yalcins/physical-ai/README.md

# Physical AI – 11/12. Sınıf Robotik Projesi
