yalcins/physical-ai/design/pcb/netlist.csv

net | ref | pin_no | pin_name
GND | U1 | 38 | GND_38
GND | J1 | 8 | GND
GND | J9 | 2 | -
GND | R2 | 2 | 2
GND | C1 | 2 | 2
GND | C2 | 2 | -
GND_L | U1 | 3 | GND_3
GND_L | J3 | 1 | GND
GND_L | J4 | 1 | GND
GND_L | J5 | 1 | GND
GND_L | J7 | 1 | ENC_GND
GND_L | J8 | 1 | ENC_GND
GND_L | C4 | 2 | 2
+3V3 | U1 | 36 | 3V3_OUT
+3V3 | W2 | 1 | 1
+3V3_L | W2 | 2 | 2
+3V3_L | J3 | 2 | VIN
+3V3_L | J4 | 2 | VIN
+3V3_L | J5 | 2 | VIN
+3V3_L | J7 | 2 | ENC_VCC
+3V3_L | J8 | 2 | ENC_VCC
+3V3_L | C4 | 1 | 1
VSYS | D1 | 1 | K
VSYS | U1 | 39 | VSYS
VBAT_SW | J9 | 1 | +
VBAT_SW | J1 | 10 | VM
VBAT_SW | J1 | 9 | VCC
VBAT_SW | D1 | 2 | A
VBAT_SW | R1 | 1 | 1
VBAT_SW | C2 | 1 | +
I2C_SDA | U1 | 6 | GP4
I2C_SDA | J3 | 3 | SDA
I2C_SDA | J4 | 3 | SDA
I2C_SDA | J5 | 3 | SDA
I2C_SCL | U1 | 7 | GP5
I2C_SCL | J3 | 4 | SCL
I2C_SCL | J4 | 4 | SCL
I2C_SCL | J5 | 4 | SCL
XSHUT_L | U1 | 9 | GP6
XSHUT_L | J3 | 5 | XSHUT
XSHUT_C | U1 | 10 | GP7
XSHUT_C | J4 | 5 | XSHUT
XSHUT_R | U1 | 11 | GP8
XSHUT_R | J5 | 5 | XSHUT
ENC_L_A | U1 | 14 | GP10
ENC_L_A | J7 | 3 | ENC_A
ENC_L_B | U1 | 15 | GP11
ENC_L_B | J7 | 4 | ENC_B
ENC_R_A | U1 | 16 | GP12
ENC_R_A | J8 | 3 | ENC_A
ENC_R_B | U1 | 17 | GP13
ENC_R_B | J8 | 4 | ENC_B
PWMA | U1 | 21 | GP16
PWMA | J1 | 1 | PWMA
AIN1 | U1 | 22 | GP17
AIN1 | J1 | 2 | AIN1
AIN2 | U1 | 24 | GP18
AIN2 | J1 | 3 | AIN2
BIN1 | U1 | 25 | GP19
BIN1 | J1 | 4 | BIN1
BIN2 | U1 | 26 | GP20
BIN2 | J1 | 5 | BIN2
PWMB | U1 | 27 | GP21
PWMB | J1 | 6 | PWMB
STBY | U1 | 29 | GP22
STBY | J1 | 7 | STBY
VBAT_SENSE | U1 | 31 | GP26
VBAT_SENSE | R1 | 2 | 2
VBAT_SENSE | R2 | 1 | 1
VBAT_SENSE | C1 | 1 | 1
