yalcins/physical-ai/docs/media/design/render-pi4-exploded.png

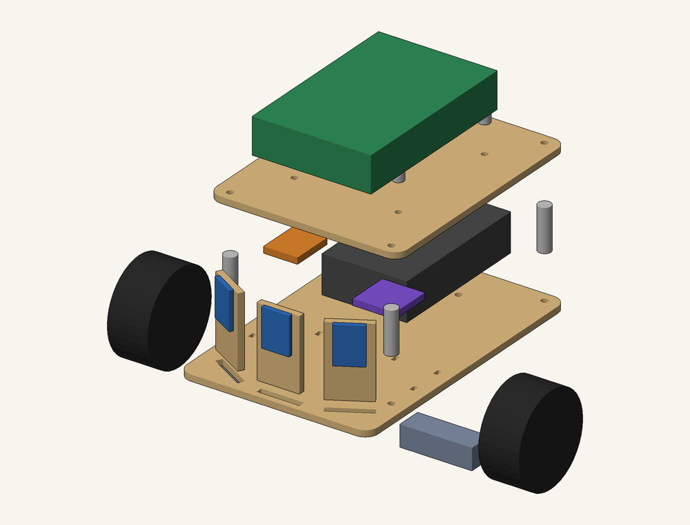
docs/media/design/render-pi4-exploded.png
