yalcins/physical-ai/docs/media/design/render-pi4-sheet.png

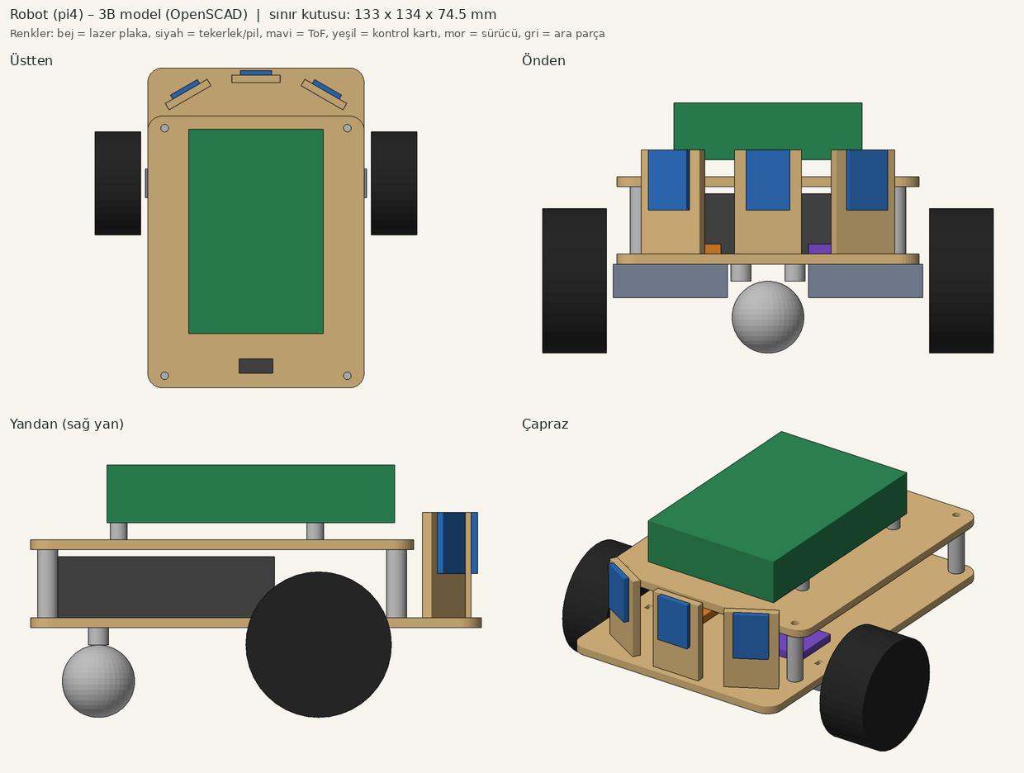
docs/media/design/render-pi4-sheet.png
