yalcins/physical-ai/docs/media/design/render-pico-exploded.png

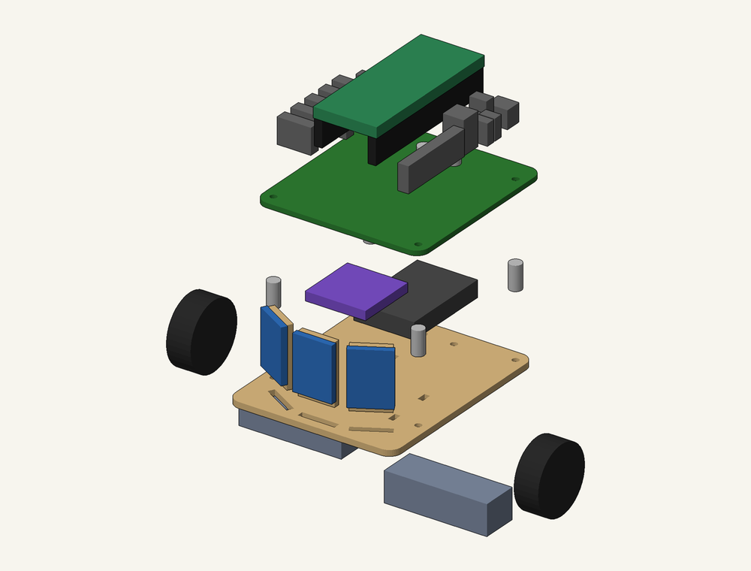
docs/media/design/render-pico-exploded.png
