yalcins/physical-ai/docs/media/design/render-pico-sheet.png

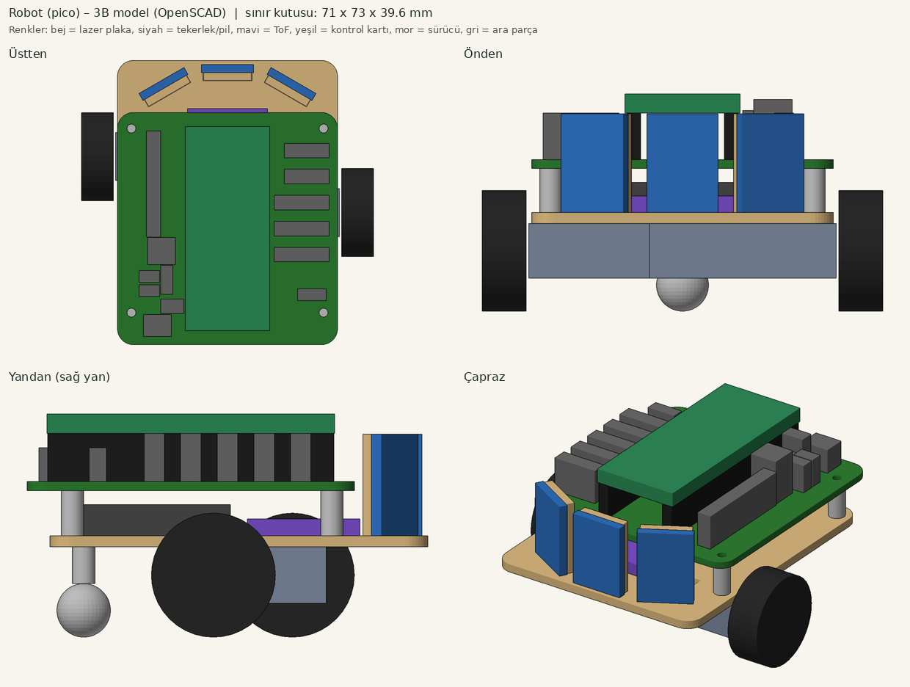
docs/media/design/render-pico-sheet.png
