yalcins/physical-ai/docs/media/pai-gym-pico2.png

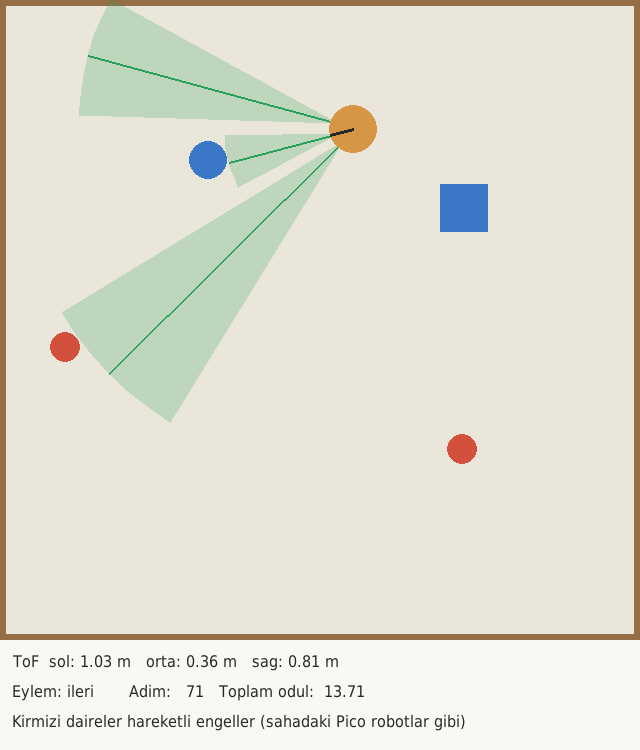
docs/media/pai-gym-pico2.png
