yalcins/physical-ai/docs/media/pai-gym.png

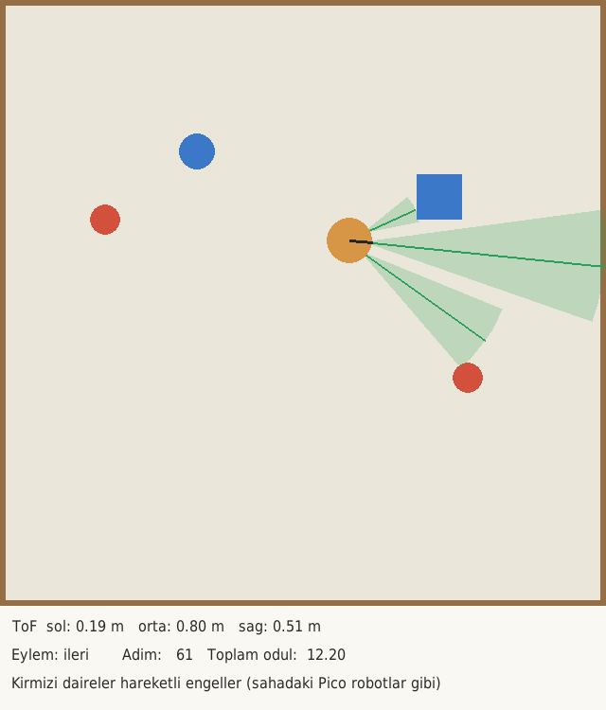
docs/media/pai-gym.png
