yalcins/physical-ai/docs/media/sim/close-front.png

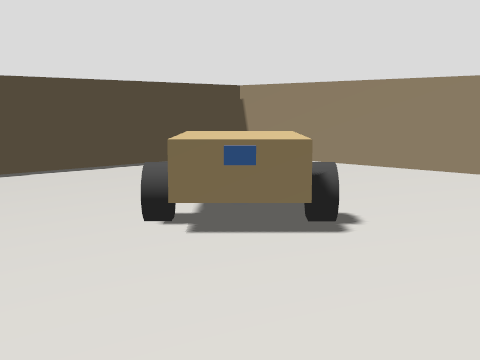
docs/media/sim/close-front.png
