yalcins/physical-ai/docs/media/sim/close-iso.png

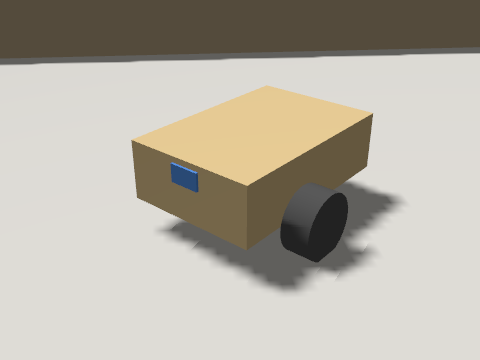
docs/media/sim/close-iso.png
