yalcins/physical-ai/docs/media/sim/close-side.png

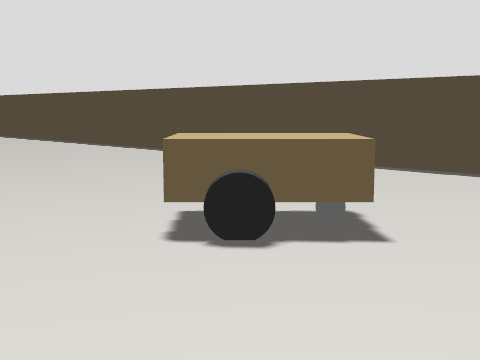
docs/media/sim/close-side.png
