yalcins/physical-ai/docs/media/sim/close-top.png

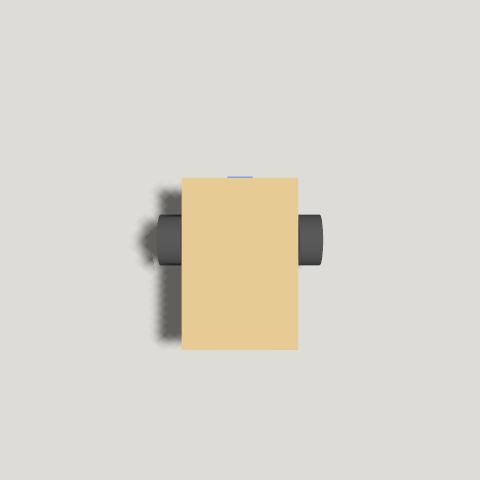
docs/media/sim/close-top.png
