yalcins/physical-ai/docs/media/sim/scene-front.png

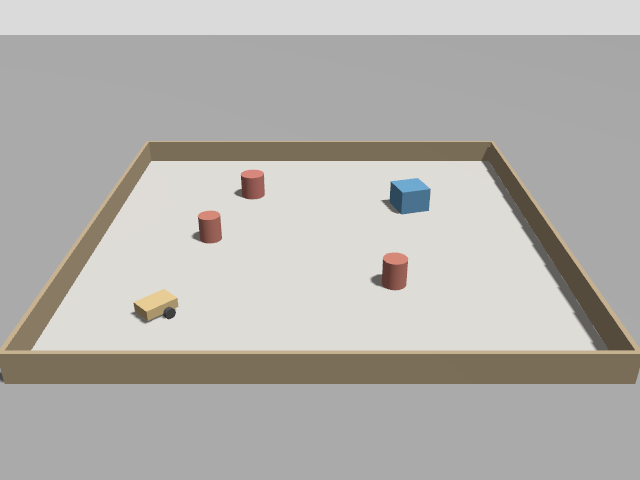
docs/media/sim/scene-front.png
