yalcins/physical-ai/docs/media/sim/scene-side.png

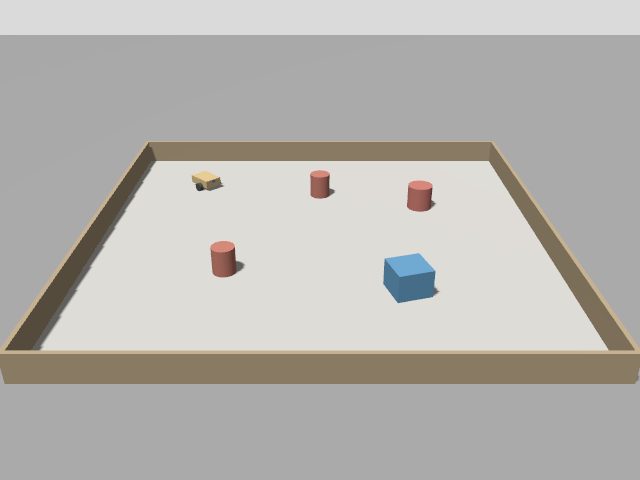
docs/media/sim/scene-side.png
