yalcins/physical-ai/docs/media/sim/scene-top.png

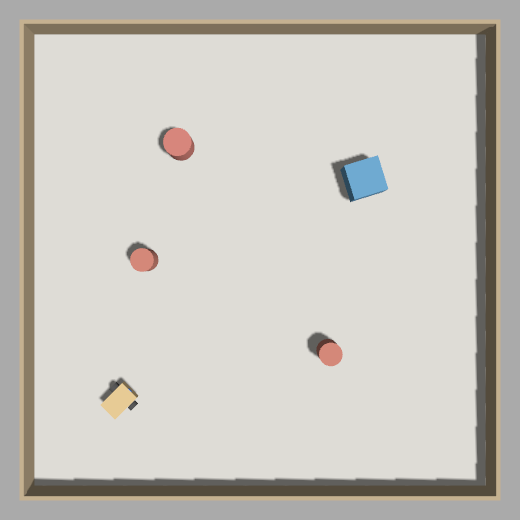
docs/media/sim/scene-top.png
