yalcins/physical-ai/docs/media/sim/trial-front.png

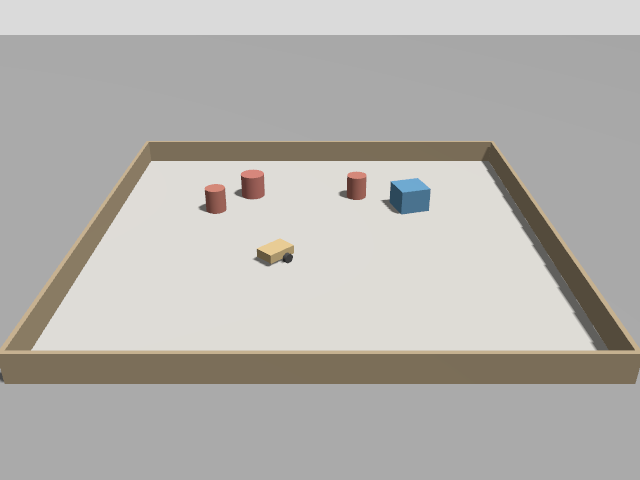
docs/media/sim/trial-front.png
