yalcins/physical-ai/docs/media/sim/trial-side.png

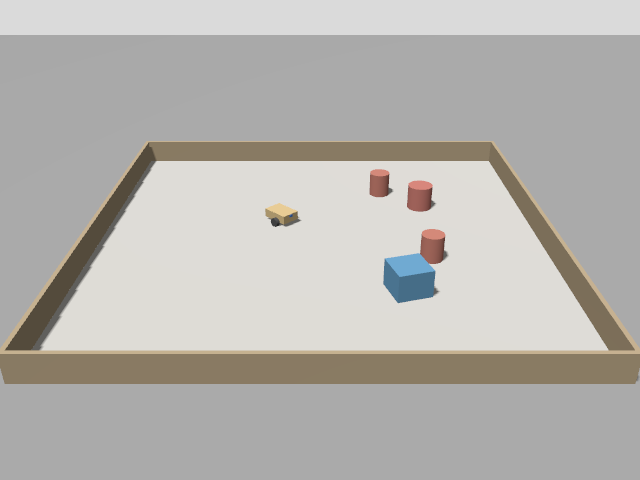
docs/media/sim/trial-side.png
