yalcins/physical-ai/docs/media/sim/trial-top.png

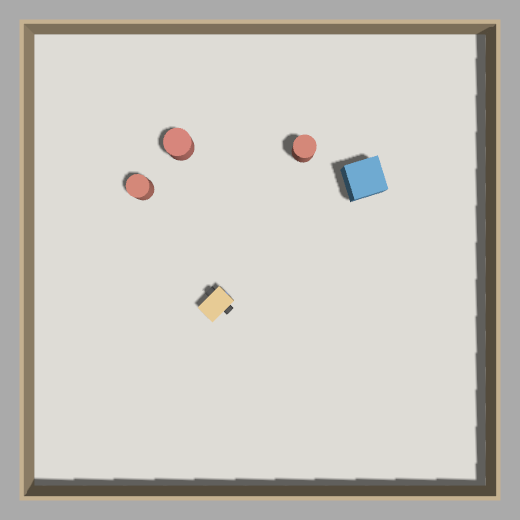
docs/media/sim/trial-top.png
