yalcins/physical-ai/design/pcb/bom.csv

ref | value | footprint | description
U1 | Raspberry Pi Pico 2 W | pico-carrier:RaspberryPi_Pico_THT | MCU modulu (2 x 20 soket)
J1 | Surucu baglantisi (TB6612) | Connector_PinHeader_2.54mm:PinHeader_1x10_P2.54mm_Vertical | TB6612 modulune 10 telli kablo
J3 | TOF400C sol | Connector_PinSocket_2.54mm:PinSocket_1x05_P2.54mm_Vertical | ToF modulu (kart sirasi: GND VIN SDA SCL XSHUT; modul kablosu pin sirasini duzeltir)
J4 | TOF400C orta | Connector_PinSocket_2.54mm:PinSocket_1x05_P2.54mm_Vertical | ToF modulu
J5 | TOF400C sag | Connector_PinSocket_2.54mm:PinSocket_1x05_P2.54mm_Vertical | ToF modulu
J7 | Sol enkoder | Connector_PinHeader_2.54mm:PinHeader_1x04_P2.54mm_Vertical | Sol motor enkoderi (sira motora gore DOGRULANACAK)
J8 | Sag enkoder | Connector_PinHeader_2.54mm:PinHeader_1x04_P2.54mm_Vertical | Sag motor enkoderi
J9 | LiPo girisi (1S) | Connector_JST:JST_PH_B2B-PH-K_1x02_P2.00mm_Vertical | JST-PH 2 pin: pil + / - (KUTUP YONUNU pile gore DOGRULA)
D1 | 1N5819 | Diode_THT:D_DO-41_SOD81_P2.54mm_Vertical_KathodeUp | Pil -> VSYS (USB ile besleme geri akisini engeller)
R1 | 100 k | Resistor_THT:R_Axial_DIN0207_L6.3mm_D2.5mm_P2.54mm_Vertical | Pil bolucu ust
R2 | 100 k | Resistor_THT:R_Axial_DIN0207_L6.3mm_D2.5mm_P2.54mm_Vertical | Pil bolucu alt
C1 | 100 nF | Capacitor_THT:C_Disc_D5.0mm_W2.5mm_P5.00mm | ADC filtresi (R2 uzerinde)
C2 | 100 uF / 10 V | Capacitor_THT:CP_Radial_D6.3mm_P2.50mm | Motor gucu (VM) depolama
C4 | 100 nF | Capacitor_THT:C_Disc_D5.0mm_W2.5mm_P5.00mm | Sensor besleme hatti
W2 | Tel kopru 3V3 | pico-carrier:WireLink_P30.48mm | +3V3 ve +3V3_L adalarini Pico'nun ustunden (yalitimli tel) birlestirir
