yalcins/physical-ai/docs/media/design/robot-pico.stl

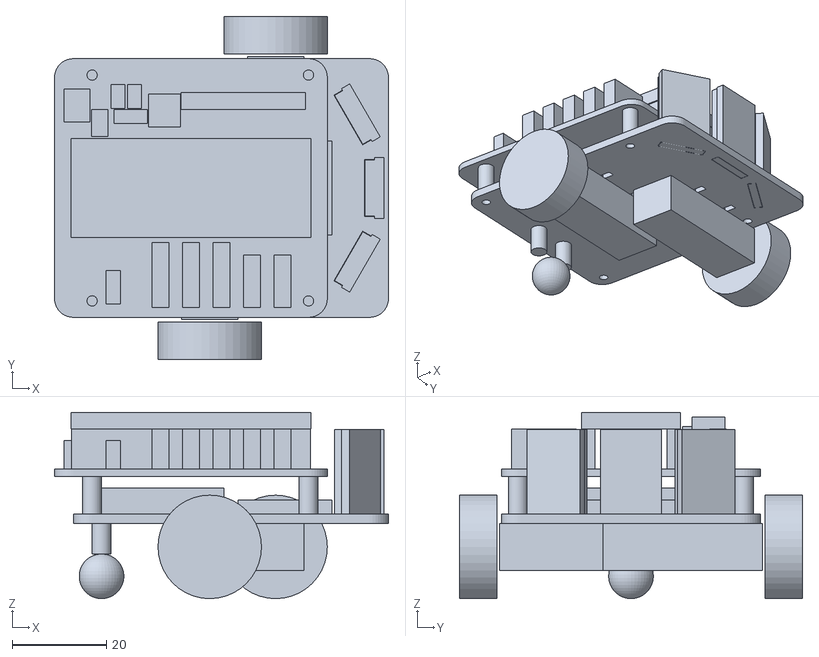
[picture p17: CAD file, 2026-10-07]
docs/media/design/robot-pico.stl
71.0 x 73.0 x 39.6
