yalcins/physical-ai/docs/media/design/plate-alt-pico.dxf

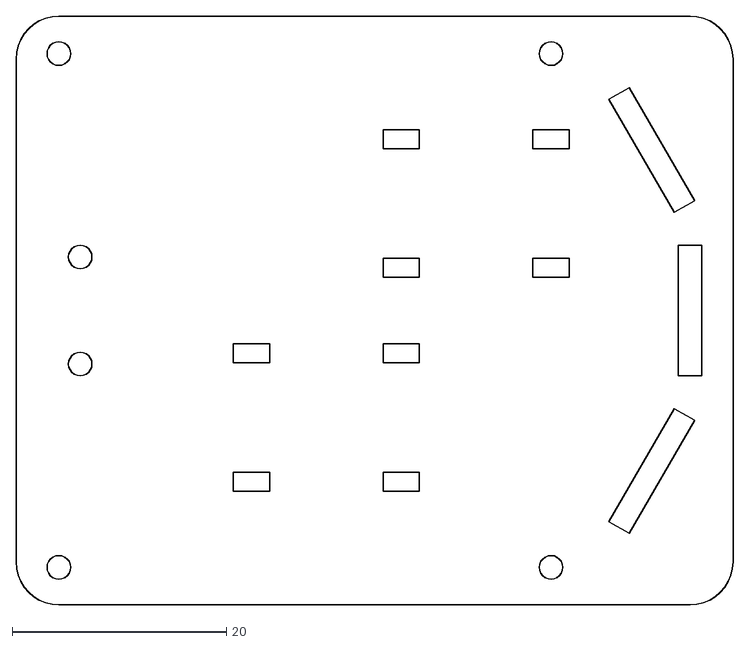
[picture p18: CAD file, 2026-10-07]
docs/media/design/plate-alt-pico.dxf
67.0 x 55.0
