yalcins/physical-ai/docs/media/design/robot-pi4.stl

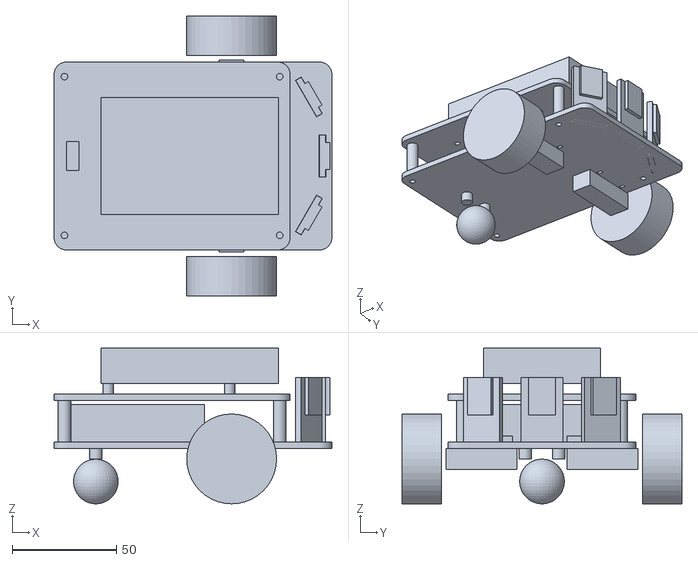
[picture p19: CAD file, 2026-10-07]
docs/media/design/robot-pi4.stl
133.0 x 134.0 x 74.5
