yalcins/physical-ai/docs/media/design/plate-ust-pi4.dxf

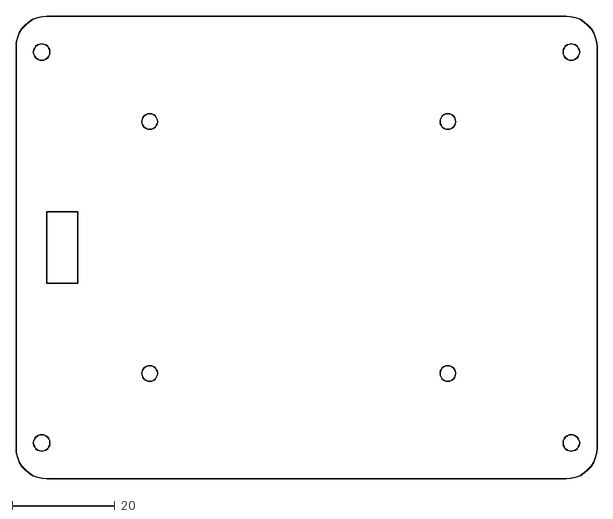
[picture p20: CAD file, 2026-10-07]
docs/media/design/plate-ust-pi4.dxf
113.0 x 90.0
