yalcins/physical-ai/docs/media/design/plate-alt-pi4.dxf

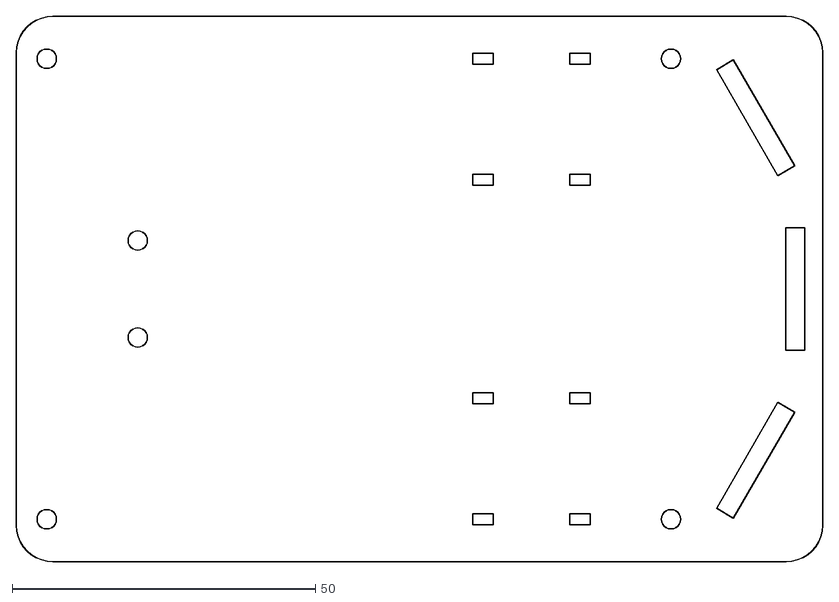
[picture p21: CAD file, 2026-10-07]
docs/media/design/plate-alt-pi4.dxf
133.0 x 90.0
