yalcins/physical-ai/design/robot_pi4.scad

// Robot (pi4) 3B modeli. Diziler generated/pi4.scad dosyasindan gelir.
include <generated/pi4.scad>
include <lib.scad>
part = "plate_bottom";
render_part(part);
