yalcins/physical-ai/design/robot_pico.scad

// Robot (pico) 3B modeli. Diziler generated/pico.scad dosyasindan gelir.
include <generated/pico.scad>
include <lib.scad>
part = "plate_bottom";
render_part(part);
