yalcins/physical-ai/design/generated/pi4.scad

// OTOMATIK URETILDI (design/design.py, varyant: pi4); elle degistirme.
OUT_B = [[-85, 48, -45, 45, 6]][0];
HOLES_B = [[23, 38, 3.2], [23, -38, 3.2], [-80, 38, 3.2], [-80, -38, 3.2], [-65, 8, 3.2], [-65, -8, 3.2]];
SLOTS_B = [[-8, 18, 3.4, 1.8, 0], [8, 18, 3.4, 1.8, 0], [-8, 38, 3.4, 1.8, 0], [8, 38, 3.4, 1.8, 0], [-8, -18, 3.4, 1.8, 0], [8, -18, 3.4, 1.8, 0], [-8, -38, 3.4, 1.8, 0], [8, -38, 3.4, 1.8, 0], [36.9689, 28.25, 20.2, 3.2, 120], [43.5, 0, 20.2, 3.2, 90], [36.9689, -28.25, 20.2, 3.2, 60]];
MARKS_B = [[-83, -20, -13, 20], [-8, 12, 12, 32], [-8, -30, 12, -14]];
Z_B = [26.5, 29.5];
OUT_T = [[-85, 28, -45, 45, 6]][0];
HOLES_T = [[23, 38, 3.2], [23, -38, 3.2], [-80, 38, 3.2], [-80, -38, 3.2], [-59, -24.5, 3.05], [-1, -24.5, 3.05], [-59, 24.5, 3.05], [-1, 24.5, 3.05]];
SLOTS_T = [[-76, 0, 6, 14, 0]];
MARKS_T = [];
Z_T = [49.5, 52.5];
BRACKET = [20, 34];
PARTS = [["cylz", "standoff_0", 23, 38, 6, 29.5, 49.5], ["cylz", "standoff_1", 23, -38, 6, 29.5, 49.5], ["cylz", "standoff_2", -80, 38, 6, 29.5, 49.5], ["cylz", "standoff_3", -80, -38, 6, 29.5, 49.5], ["box", "plate_bottom", -85, 48, -45, 45, 26.5, 29.5], ["box", "plate_top", -85, 28, -45, 45, 49.5, 52.5], ["cyly", "wheel_l", 0, 21.5, 48, 67, 43], ["box", "motor_l", -6, 6, 12, 46, 16.5, 26.5], ["cyly", "wheel_r", 0, 21.5, -67, -48, 43], ["box", "motor_r", -6, 6, -46, -12, 16.5, 26.5], ["sphere", "caster_ball", -65, 0, 10.7, 10.7], ["cylz", "caster_spacer_p", -65, 8, 6, 21.4, 26.5], ["cylz", "caster_spacer_n", -65, -8, 6, 21.4, 26.5], ["rbox", "tof_bracket_left", 36.9689, 28.25, 20, 3, 26.5, 60.5, 30], ["rbox", "tof_left", 39.134, 29.5, 13, 2, 42.5, 60.5, 30], ["rbox", "tof_bracket_center", 43.5, 0, 20, 3, 26.5, 60.5, 0], ["rbox", "tof_center", 46, 0, 13, 2, 42.5, 60.5, 0], ["rbox", "tof_bracket_right", 36.9689, -28.25, 20, 3, 26.5, 60.5, -30], ["rbox", "tof_right", 39.134, -29.5, 13, 2, 42.5, 60.5, -30], ["box", "power_placeholder", -83, -13, -20, 20, 29.5, 47.5], ["box", "tb6612", -8, 12, 12, 32, 29.5, 32.5], ["box", "mpu6050", -8, 12, -30, -14, 29.5, 32.5], ["cylz", "pi4_spacer_22", -59, -24.5, 5, 52.5, 57.5], ["cylz", "pi4_spacer_23", -1, -24.5, 5, 52.5, 57.5], ["cylz", "pi4_spacer_24", -59, 24.5, 5, 52.5, 57.5], ["cylz", "pi4_spacer_25", -1, 24.5, 5, 52.5, 57.5], ["box", "pi4", -62.5, 22.5, -28, 28, 57.5, 74.5]];
