yalcins/physical-ai/design/generated/pico.scad

// OTOMATIK URETILDI (design/design.py, varyant: pico); elle degistirme.
OUT_B = [[-36, 31, -27.5, 27.5, 4]][0];
HOLES_B = [[14, 24, 2.2], [14, -24, 2.2], [-32, 24, 2.2], [-32, -24, 2.2], [-30, 5, 2.2], [-30, -5, 2.2]];
SLOTS_B = [[0, 4, 3.4, 1.8, 0], [14, 4, 3.4, 1.8, 0], [0, 16, 3.4, 1.8, 0], [14, 16, 3.4, 1.8, 0], [-14, -4, 3.4, 1.8, 0], [0, -4, 3.4, 1.8, 0], [-14, -16, 3.4, 1.8, 0], [0, -16, 3.4, 1.8, 0], [23.4019, 15, 12.2, 2.2, 120], [27, 0, 12.2, 2.2, 90], [23.4019, -15, 12.2, 2.2, 60]];
MARKS_B = [[-34, -10, -4, 10], [-1, -10, 19, 10]];
Z_B = [16, 18];
OUT_T = [[-40, 18, -27.5, 27.5, 4]][0];
HOLES_T = [[14, 24, 2.2], [14, -24, 2.2], [-32, 24, 2.2], [-32, -24, 2.2]];
SLOTS_T = [];
MARKS_T = [];
Z_T = [26, 27.6];
BRACKET = [12, 20];
PARTS = [["box", "plate_bottom", -36, 31, -27.5, 27.5, 16, 18], ["box", "plate_top", -40, 18, -27.5, 27.5, 26, 27.6], ["cylz", "standoff_1", 14, 24, 4, 18, 26], ["cylz", "standoff_2", 14, -24, 4, 18, 26], ["cylz", "standoff_3", -32, 24, 4, 18, 26], ["cylz", "standoff_4", -32, -24, 4, 18, 26], ["cyly", "wheel_l", 7, 11, 28.5, 36.5, 22], ["box", "motor_l", 1, 13, -6, 28, 6, 16], ["cyly", "wheel_r", -7, 11, -36.5, -28.5, 22], ["box", "motor_r", -13, -1, -28, 6, 6, 16], ["sphere", "caster_ball", -30, 0, 4.75, 4.75], ["cylz", "caster_spacer_p", -30, 5, 4, 9.5, 16], ["cylz", "caster_spacer_n", -30, -5, 4, 9.5, 16], ["rbox", "tof_bracket_left", 23.4019, 15, 12, 2, 16, 36, 30], ["rbox", "tof_left", 25.134, 16, 13, 2, 18, 36, 30], ["rbox", "tof_bracket_center", 27, 0, 12, 2, 16, 36, 0], ["rbox", "tof_center", 29, 0, 13, 2, 18, 36, 0], ["rbox", "tof_bracket_right", 23.4019, -15, 12, 2, 16, 36, -30], ["rbox", "tof_right", 25.134, -16, 13, 2, 18, 36, -30], ["box", "battery", -34, -4, -10, 10, 18, 23.5], ["box", "tb6612", -1, 19, -10, 10, 18, 21], ["box", "pico_socket_l", -36.4, 14.4, 7.62, 10.16, 27.6, 36.1], ["box", "pico_socket_r", -36.4, 14.4, -10.16, -7.62, 27.6, 36.1], ["box", "pico", -36.5, 14.5, -10.5, 10.5, 36.1, 39.6], ["box", "j1_part", -13.15, 13.35, 16.7, 20.3, 27.6, 36.1], ["box", "j3_part", -19.3, -15.7, -25.4, -11.6, 27.6, 36.1], ["box", "j4_part", -12.8, -9.2, -25.4, -11.6, 27.6, 36.1], ["box", "j5_part", -6.3, -2.7, -25.4, -11.6, 27.6, 36.1], ["box", "j7_part", 0.2, 3.8, -25.4, -14.2, 27.6, 36.1], ["box", "j8_part", 6.7, 10.3, -25.4, -14.2, 27.6, 36.1], ["box", "j9_part", -37.95, -32.45, 14, 21, 27.6, 33.6], ["box", "d1_part", -32.15, -28.65, 10.95, 16.65, 27.6, 36.6], ["box", "r1_part", -24.5, -21.5, 16.95, 22.05, 27.6, 34.6], ["box", "r2_part", -28, -25, 16.95, 22.05, 27.6, 34.6], ["box", "c1_part", -27.4, -20.2, 13.7, 16.7, 27.6, 33.6], ["box", "c2_part", -20, -13.2, 13, 20, 27.6, 38.6], ["box", "c4_part", -29, -26, -24.7, -17.5, 27.6, 33.6]];
