yalcins/physical-ai/design/pcb/kicad/pico-carrier.kicad_pcb

## KiCad design design/pcb/kicad/pico-carrier.kicad_pcb (2026-10-07)

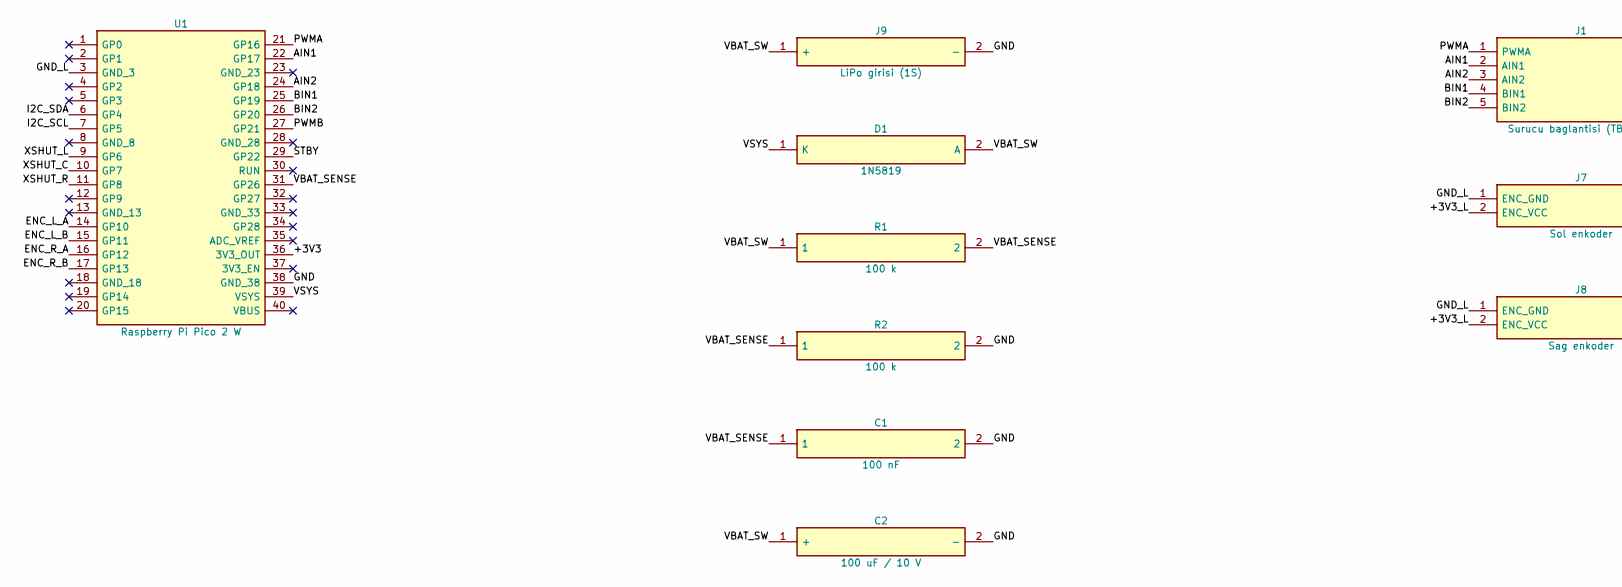
[picture p22: schematic pico-carrier.kicad_sch, part in row 1, column 1]

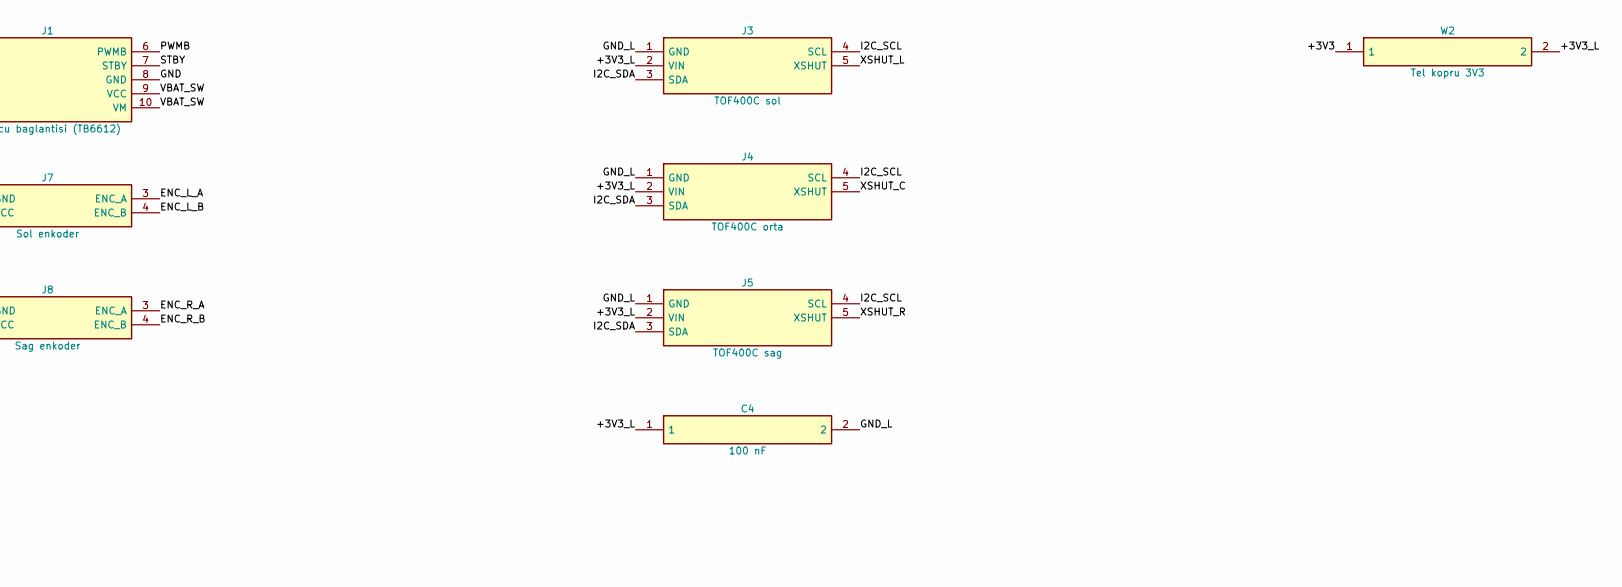
[picture p23: schematic pico-carrier.kicad_sch, part in row 1, column 2]

Parts:
C1, C4: 100 nF; C_Disc_D5.0mm_W2.5mm_P5.00mm
C2: 100 uF / 10 V; CP_Radial_D6.3mm_P2.50mm
D1: 1N5819; D_DO-41_SOD81_P2.54mm_Vertical_KathodeUp
J1: Surucu baglantisi (TB6612); PinHeader_1x10_P2.54mm_Vertical
J3: TOF400C sol; PinSocket_1x05_P2.54mm_Vertical
J4: TOF400C orta; PinSocket_1x05_P2.54mm_Vertical
J5: TOF400C sag; PinSocket_1x05_P2.54mm_Vertical
J7: Sol enkoder; PinHeader_1x04_P2.54mm_Vertical
J8: Sag enkoder; PinHeader_1x04_P2.54mm_Vertical
J9: LiPo girisi (1S); JST_PH_B2B-PH-K_1x02_P2.00mm_Vertical
R1, R2: 100 k; R_Axial_DIN0207_L6.3mm_D2.5mm_P2.54mm_Vertical
U1: Raspberry Pi Pico 2 W; RaspberryPi_Pico_THT
W2: Tel kopru 3V3; WireLink_P30.48mm

Connections:
+3V3: U1.36 (3V3_OUT), W2.1
+3V3_L: C4.1, J3.2 (VIN), J4.2 (VIN), J5.2 (VIN), J7.2 (ENC_VCC), J8.2 (ENC_VCC), W2.2
AIN1: J1.2 (AIN1), U1.22 (GP17)
AIN2: J1.3 (AIN2), U1.24 (GP18)
BIN1: J1.4 (BIN1), U1.25 (GP19)
BIN2: J1.5 (BIN2), U1.26 (GP20)
ENC_L_A: J7.3 (ENC_A), U1.14 (GP10)
ENC_L_B: J7.4 (ENC_B), U1.15 (GP11)
ENC_R_A: J8.3 (ENC_A), U1.16 (GP12)
ENC_R_B: J8.4 (ENC_B), U1.17 (GP13)
GND: C1.2, C2.2 (-), J1.8 (GND), J9.2 (-), R2.2, U1.38 (GND_38)
GND_L: C4.2, J3.1 (GND), J4.1 (GND), J5.1 (GND), J7.1 (ENC_GND), J8.1 (ENC_GND), U1.3 (GND_3)
I2C_SCL: J3.4 (SCL), J4.4 (SCL), J5.4 (SCL), U1.7 (GP5)
I2C_SDA: J3.3 (SDA), J4.3 (SDA), J5.3 (SDA), U1.6 (GP4)
PWMA: J1.1 (PWMA), U1.21 (GP16)
PWMB: J1.6 (PWMB), U1.27 (GP21)
STBY: J1.7 (STBY), U1.29 (GP22)
VBAT_SENSE: C1.1, R1.2, R2.1, U1.31 (GP26)
VBAT_SW: C2.1 (+), D1.2 (A), J1.9 (VCC), J1.10 (VM), J9.1 (+), R1.1
VSYS: D1.1 (K), U1.39 (VSYS)
XSHUT_C: J4.5 (XSHUT), U1.10 (GP7)
XSHUT_L: J3.5 (XSHUT), U1.9 (GP6)
XSHUT_R: J5.5 (XSHUT), U1.11 (GP8)

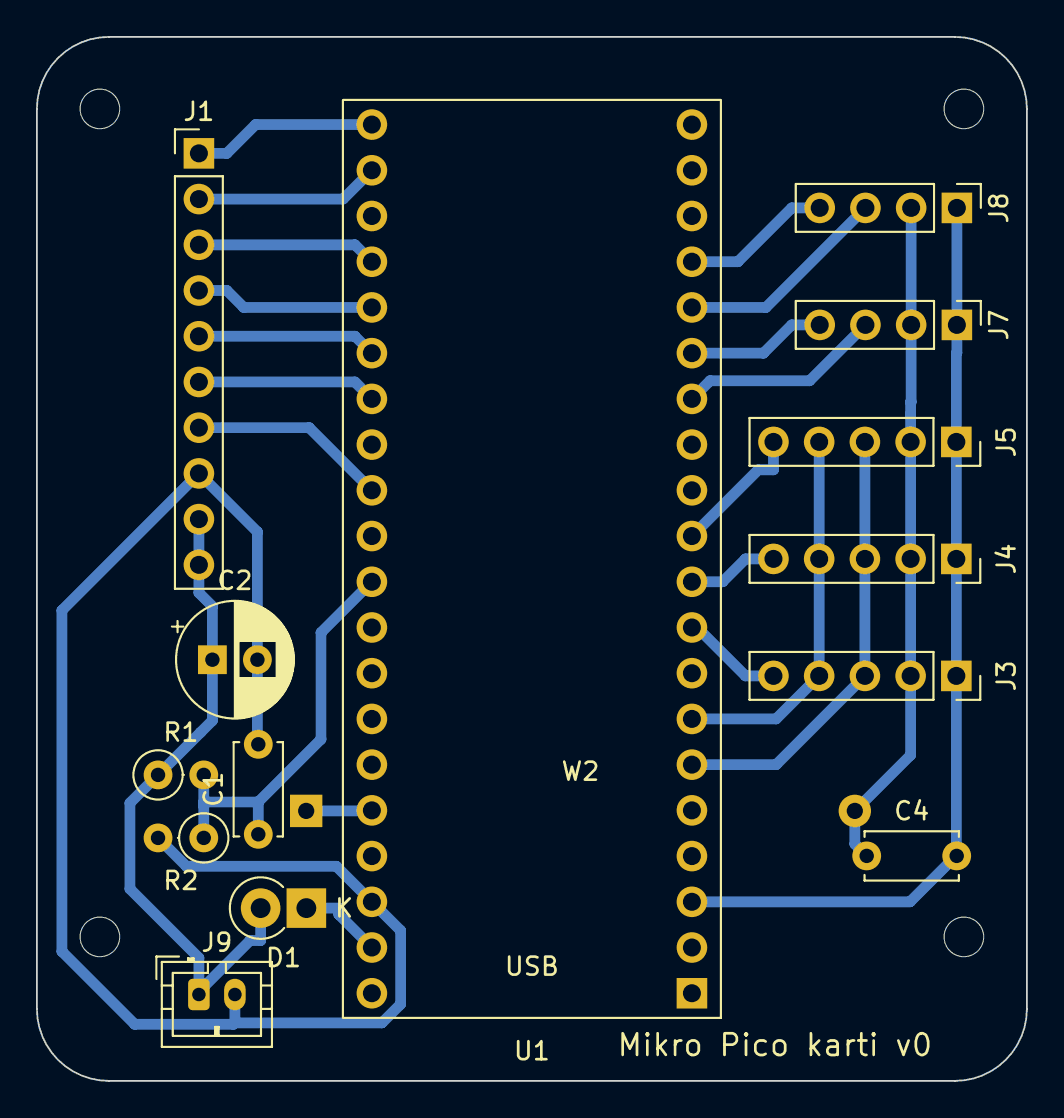
[picture p24: board pico-carrier.kicad_pcb from above]

Board: 2 copper layers, 55.0 x 58.0 mm, 19 parts (0 on the bottom side), 23 nets.

Other parts of the board:
H1, H2, H3, H4: MountingHole_2.2mm_M2
