yalcins/physical-ai/(commit log)

2026-09-29 arena_sim: ROS 2 Gazebo dijital ikiz paketi ekle
    [arena.sdf, pai_bot.urdf]
2026-09-29 pai_gym: --frames seçeneği ile kısa hafıza (önceki ToF ölçümleri) ekle
2026-09-30 arena_sim: Gazebo'ya duvardan seken hareketli engeller ekle
    [arena.sdf]
2026-10-01 Sensor duzeni secenegi: side5 (3 on + 2 yan ToF)
    ArenaEnv, train.py ve play.py icin --layout; export_site_config.py side5 uretir.
    front3 sonuclari degismedi (kuralli kontrolcu kayitli olcumle birebir ayni).
2026-10-06 Mimari: iki tur gercek robot (kucuk Pico 2 W rastgele, buyuk Pi 4 gorev cozen)
2026-10-06 Ortak robot arayuzu, Pico 2 W firmware, Pi 4 calistirici, ana bilgisayar filo araci
    Gercek donanimda denenmedi; testler sahte Pico ile.
2026-10-06 Yapim rehberi: Pico tezgah denemesi parca etiketleri ve yardimci parcalar
2026-10-06 Yapim rehberi: Pico tezgah adimlari duzeltildi (guc/GND, kodsuz kontroller, testler asama 4'e)
2026-10-06 Pi 4: tof.py (XSHUT adres atama + VL53L1X okuma), surucuye baglandi, sahte sensor testleri
    Gercek sensorle denenmedi.
2026-10-06 Pico ToF gercek kutuphaneye gore (vl53l1x_pico), adres atamasi tof.py'de, sahte modul testi; tablo aciklamalari guncellendi
    Gercek kartta ve sensorle denenmedi.
2026-10-06 Pico: Wi-Fi zaman asimi ve motorlar kapali baslangic, ilk calistirma adimi (tekerlekler yerden kesik)
    Gercek kartta denenmedi; testler sahte modullerle.
2026-10-06 Pi 4: run.sh (surucu + politika baslat/durdur, pid dosyalari, SIGTERM), fleet.py run.sh uzerinden, .venv-pi adimi, adim metinleri
    Gercek Pi 4'te denenmedi; testler sahte surecle.
2026-10-06 Simulator: senaryo dosyalari, gercek Pico benzeri engel (PicoBot), gerceğe benzetme bozukluklari, 18 birim testi
    Varsayilan davranis degismedi: ayni tohumla ppo_pai_f3 bolum sonuclari birebir ayni.
2026-10-07 Pico tezgah test betigi (bench_test.py); 3 yonlu Gazebo kayit araci; teknik cizim uretici
    Gercek kartta denenmedi; test sahte machine modulu ile.
2026-10-07 Medya: Gazebo son deneme (ust/on/yan), tum simulasyon ve robot yakin cekim, Pico engelli Python videosu, teknik cizimler (SVG)
2026-10-07 Site: gruplar ve gorevler, bugunku Pico denemesi, teknik cizimler, 3 yonlu simulasyon; ust yazi ve alt '11. ve 12. siniflar' kaldirildi, baslik tiklaninca en uste doner
2026-10-07 Sanal tasarim v0: tek kaynakli robot tasarimi (design.py), OpenSCAD 3B model, lazer SVG/DXF uretimi, STL cizici, BOM ve kablolama, cakisma/delik payi testleri
    Parca olculerinin bir kismi varsayim (yildizli); gercek parcalarla dogrulanmadi.
    [lib.scad, pi4.scad, pico.scad, robot_pi4.scad, robot_pico.scad]
2026-10-07 Kalibrasyon hatti (calibrate.py, olcum sablonlari), simulasyon seçenekleri (robot_radius, sensor_noise_std, calibration), Pi 4 pin onerisi, URDF 133 mm, ROS testi ve yetim surec duzeltmesi
    [pai_bot.urdf]
2026-10-07 Site: sanal prototip bolumu (3B goruntuler, indirmeler, BOM, kablolama, kalibrasyon), tasarimdan uretilen teknik resimler, yeni Gazebo kayitlari, bulgular, olgunluk tablosu
    [plate-alt-pi4.dxf, plate-alt-pico.dxf, plate-ust-pi4.dxf, plate-ust-pico.dxf, robot-pi4.stl, robot-pico.stl]
2026-10-07 PCB semasi: Pico tasiyici karti (pcb_design.py), KiCad netlist, net etiketli sematik, elektrik ve firmware-pin testleri; site ve adimlar
    KiCad kurulu degil: sema/netlist KiCad'de acilmadi.
    [bom.csv, netlist.csv]
2026-10-07 KiCad 7: sema, kart yerlesimi ve yonlendirme (Freerouting), DRC, Gerber; Pico footprint'i, testler, site
    KiCad kendi okuyucusuyla aglari dogruladi; kart ust plakanin yerine gecer. Frezelenmedi; modul pin siralari dogrulanacak.
    [bom.csv, netlist.csv, pico-carrier.kicad_pcb, pico-carrier.kicad_sch]
2026-10-07 Mikro Pico robot: simulasyon sabitleri, firmware olculeri, mikro engellerle yeniden olculen deneyler
2026-10-07 Mikro robot tasarimi (65 x 55, O22 tekerlek, 1S LiPo); Pi 4 buyuk robot BIG_SPEC olarak kaldi
    [pico.scad, plate-alt-pico.dxf, plate-ust-pico.dxf, robot-pico.stl]
2026-10-07 Tek katmanli Pico karti (55 x 58): konnektor siralari, tek tel kopru, Freerouting job_timeout, tek katman testleri
    [bom.csv, netlist.csv, pico-carrier.kicad_pcb, pico-carrier.kicad_sch]
2026-10-07 Site ve notlar: mikro robot, tek katmanli PCB, is plani ve CLAUDE.md guncellemesi
